Spaceflakes/Sid-FPV-timer/PCB/Sid_FPV_Timer.csv

Reference | Qty | Value | DNP | Exclude from BOM | Exclude from Board | Footprint | Datasheet | LCSC
BT1 | 1 | CR2032-BS-6-1 |  |  |  | Battery:BatteryHolder_Keystone_1060_1x2032 | https://snapeda.s3.amazonaws.com/datasheets/1811061923_Q-J-CR2032-BS-6-1_C70377.pdf
BZ1 | 1 | Buzzer |  |  |  | Hex_FPV_Timer:Buzzer 9650Y
C1 | 1 | 220u |  |  |  | Capacitor_SMD:CP_Elec_10x10 |  | C2887271
C2,C3,C4,C5 | 4 | 4.7u |  |  |  | Capacitor_SMD:C_0603_1608Metric
C6,C7,C8 | 3 | 47u |  |  |  | Capacitor_SMD:C_0603_1608Metric
C9,C10,C21,C22 | 4 | 220n |  |  |  | Capacitor_SMD:C_0603_1608Metric
C11,C23,C31,C32 | 4 | 1u |  |  |  | Capacitor_SMD:C_0603_1608Metric
C12,C24,C26,C27,C28,C33 | 6 | 100n |  |  |  | Capacitor_SMD:C_0603_1608Metric
C13 | 1 | 1p |  |  |  | Capacitor_SMD:C_0603_1608Metric
C14,C15,C16,C17,C29 | 5 | 10u |  |  |  | Capacitor_SMD:C_0603_1608Metric
C18,C19,C20 | 3 | 100u |  |  |  | Capacitor_SMD:C_0603_1608Metric
C25 | 1 | 30p |  |  |  | Capacitor_SMD:C_0603_1608Metric
C30 | 1 | 10n |  |  |  | Capacitor_SMD:C_0603_1608Metric
D1 | 1 | SMC26A |  |  |  | Diode_SMD:D_SMC
D2,D3 | 2 | Red |  |  |  | LED_SMD:LED_0805_2012Metric
D4 | 1 | Blue |  |  |  | LED_SMD:LED_0603_1608Metric
D5,D6 | 2 | Yellow |  |  |  | LED_SMD:LED_0805_2012Metric
FB1 | 1 | 100m, 120r
J1 | 1 | Input |  |  |  | Connector_AMASS:AMASS_XT60PW-M_1x02_P7.20mm_Horizontal
J2 | 1 | Fan 1 |  |  |  | Connector_JST:JST_XA_B02B-XASK-1_1x02_P2.50mm_Vertical
J3 | 1 | Raspberry_Pi_4 |  |  |  | Connector_PinSocket_2.54mm:PinSocket_2x20_P2.54mm_Vertical | https://datasheets.raspberrypi.com/rpi4/raspberry-pi-4-datasheet.pdf
J4 | 1 | LED1 |  |  |  | Connector_JST:JST_XH_B3B-XH-A_1x03_P2.50mm_Vertical
J5 | 1 | LED2 |  |  |  | Connector_JST:JST_XH_B3B-XH-A_1x03_P2.50mm_Vertical
J6 | 1 | FTDI |  |  |  | Connector_PinHeader_2.54mm:PinHeader_1x06_P2.54mm_Vertical
L1 | 1 | 6.8u |  |  |  | Inductor_SMD:L_7.3x7.3_H3.5 |  | C41415571
L2 | 1 | 4.7u |  |  |  | Inductor_SMD:L_7.3x7.3_H3.5 |  | C167220
Q1,Q2 | 2 | AO3400A |  |  |  | Package_TO_SOT_SMD:SOT-23 | http://www.aosmd.com/pdfs/datasheet/AO3400A.pdf
R1,R6 | 2 | 32.4k |  |  |  | Resistor_SMD:R_0603_1608Metric
R2,R3,R7,R8,R12,R20,R21,R22,R23,R24,R25,R26,R27,R28,R29 | 15 | 100k |  |  |  | Resistor_SMD:R_0603_1608Metric
R4,R9,R15,R16,R18,R19 | 6 | 1k |  |  |  | Resistor_SMD:R_0603_1608Metric
R5 | 1 | 24.9k |  |  |  | Resistor_SMD:R_0603_1608Metric
R10 | 1 | 43.2k |  |  |  | Resistor_SMD:R_0603_1608Metric
R11,R13,R14,R30 | 4 | 10k |  |  |  | Resistor_SMD:R_0603_1608Metric
R17 | 1 | 68 |  |  |  | Resistor_SMD:R_0603_1608Metric
SW1 | 1 | SW_Push |  |  |  | Button_Switch_SMD:Panasonic_EVQPUJ_EVQPUA
U1,U2 | 2 | LM61460AFSQRJRRQ1 |  |  |  | TI:IC_LM61460AFSQRJRRQ1
U3 | 1 | ESP32-WROOM-32UE |  |  |  | RF_Module:ESP32-WROOM-32UE | https://www.espressif.com/sites/default/files/documentation/esp32-wroom-32e_esp32-wroom-32ue_datasheet_en.pdf
U4 | 1 | STM32F103C8Tx |  |  |  | Package_QFP:LQFP-48_7x7mm_P0.5mm | https://www.st.com/resource/en/datasheet/stm32f103c8.pdf
U5,U6,U7,U8,U9,U10,U11,U12 | 8 |  |  |  |  | Hex_FPV_Timer:RX5808_Module
Y1 | 1 | 8m |  |  |  | Crystal:Resonator_SMD_Murata_CSTxExxV-3Pin_3.0x1.1mm
