Spaceflakes/Sid-FPV-timer/PCB/Sid_FPV_Timer.kicad_pcb

## KiCad design PCB/Sid_FPV_Timer.kicad_pcb (2026-11-07)

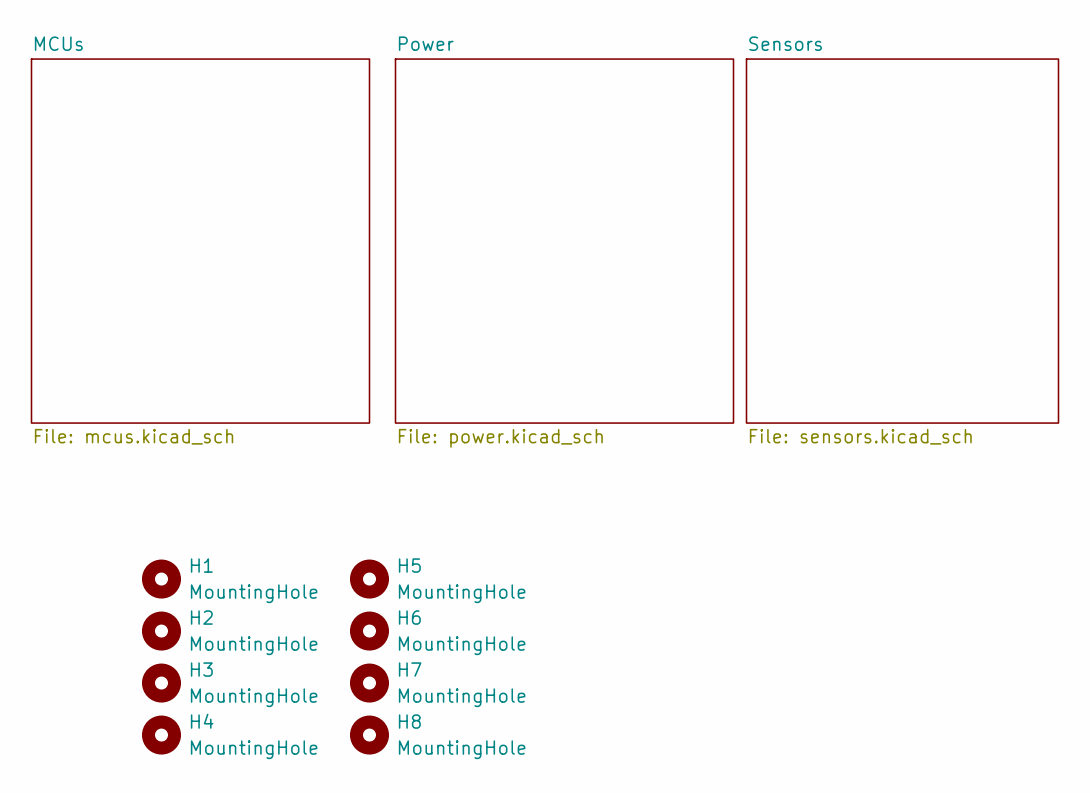
[picture p1: schematic Sid_FPV_Timer.kicad_sch, HEX FPV TIMER]

Parts:
H1, H2, H3, H4: MountingHole; MountingHole_2.7mm_M2.5_Pad_Via
H5, H6, H7, H8: MountingHole; MountingHole_3.2mm_M3_Pad_Via

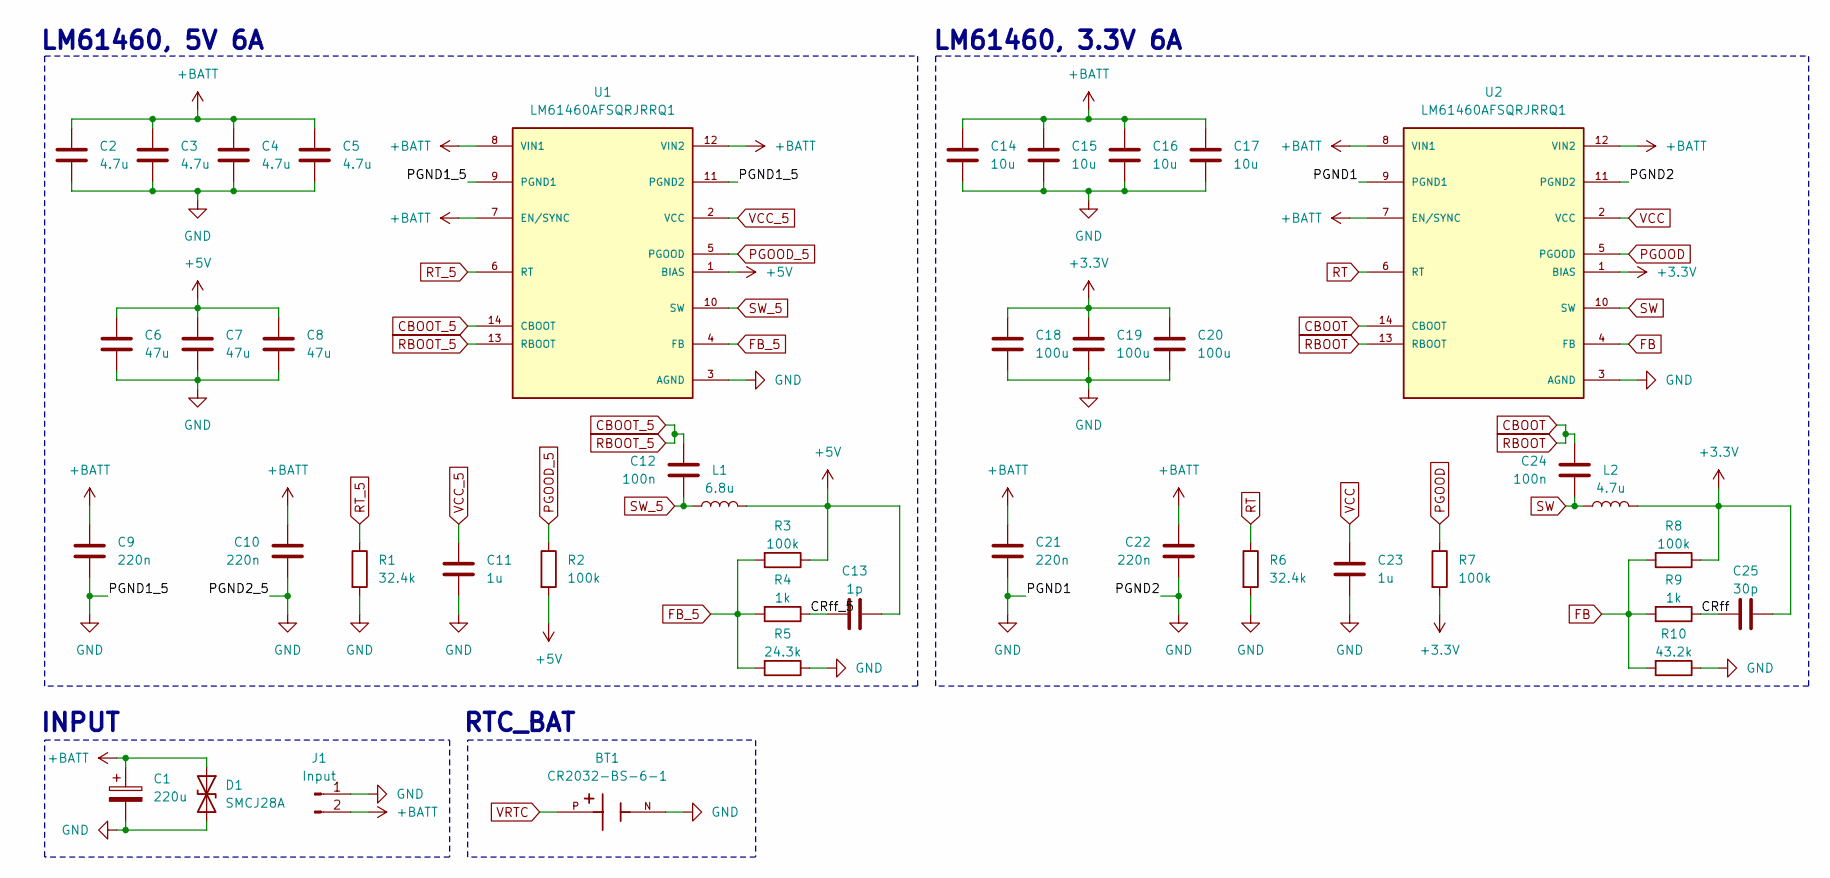
[picture p2: schematic power.kicad_sch]

Parts:
BT1: CR2032-BS-6-1; BatteryHolder_Keystone_1060_1x2032; MPN CR2032-BS-6-1; LCSC C964758
C1: 220u; CP_Elec_10x10; LCSC C2887271
C2, C3, C4, C5: 4.7u; C_0805_2012Metric; LCSC C98192
C6, C7, C8: 47u; C_0603_1608Metric; LCSC C730416
C9, C10, C21, C22: 220n; C_0603_1608Metric; LCSC C64705
C11, C23: 1u; C_0603_1608Metric; LCSC C15849
C12, C24: 100n; C_0603_1608Metric; LCSC C1591
C13: 1p; C_0603_1608Metric; LCSC C5137611
C14, C15, C16, C17: 10u; C_0805_2012Metric; LCSC C440198
C18, C19, C20: 100u; C_0805_2012Metric; LCSC C141660
C25: 30p; C_0603_1608Metric; LCSC C113797
D1: SMCJ28A; D_SMC; LCSC C42371538
J1: Input; AMASS_XT60PW-M_1x02_P7.20mm_Horizontal; LCSC C98732
L1: 6.8u; L_7.3x7.3_H3.5; LCSC C41415571
L2: 4.7u; L_7.3x7.3_H3.5; LCSC C167220
R1, R6: 32.4k; R_0603_1608Metric; LCSC C2982943
R2, R3, R7, R8: 100k; R_0603_1608Metric; LCSC C122538
R4, R9: 1k; R_0603_1608Metric; LCSC C118155
R5: 24.3k; R_0603_1608Metric; LCSC C403097
R10: 43.2k; R_0603_1608Metric; LCSC C2930102
U1, U2: LM61460AFSQRJRRQ1; IC_LM61460AFSQRJRRQ1; PARTREV D; LCSC C2864505

Connections:
+5V: C6.1, C7.1, C8.1, C13.2, L1.2, R2.2, R3.1, U1.1 (BIAS); also elsewhere on the board
+BATT: C1.1, C2.1, C3.1, C4.1, C5.1, C9.1, C10.1, C14.1, C15.1, C16.1, C17.1, C21.1, C22.1, D1.1 (A1), J1.2, U1.7 (EN/SYNC), U1.8 (VIN1), U1.12 (VIN2), U2.7 (EN/SYNC), U2.8 (VIN1), U2.12 (VIN2); also elsewhere on the board
/Power/CRff: C25.1, R9.1
/Power/CRff_5: C13.1, R4.1
CBOOT: C24.2, U2.13 (RBOOT), U2.14 (CBOOT)
CBOOT_5: C12.2, U1.13 (RBOOT), U1.14 (CBOOT)
FB: R8.2, R9.2, R10.2, U2.4 (FB)
FB_5: R3.2, R4.2, R5.2, U1.4 (FB)
GND: BT1.N, C1.2, C2.2, C3.2, C4.2, C5.2, C6.2, C7.2, C8.2, C9.2, C10.2, C11.2, C14.2, C15.2, C16.2, C17.2, C18.2, C19.2, C20.2, C21.2, C22.2, C23.2, D1.2 (A2), J1.1, R1.2, R5.1, R6.2, R10.1, U1.3 (AGND), U1.9 (PGND1), U1.11 (PGND2), U2.3 (AGND), U2.9 (PGND1), U2.11 (PGND2); also elsewhere on the board
PGOOD: R7.1, U2.5 (PGOOD)
PGOOD_5: R2.1, U1.5 (PGOOD)
RT: R6.1, U2.6 (RT)
RT_5: R1.1, U1.6 (RT)
SW: C24.1, L2.1, U2.10 (SW)
SW_5: C12.1, L1.1, U1.10 (SW)
VCC: C23.1, U2.2 (VCC)
VCC_5: C11.1, U1.2 (VCC)
VDD: C18.1, C19.1, C20.1, C25.2, L2.2, R7.2, R8.1, U2.1 (BIAS); also elsewhere on the board
VRTC: BT1.P; also elsewhere on the board

Notes on the sheet:
LM61460, 5V 6A
LM61460, 3.3V 6A
RTC_BAT
INPUT

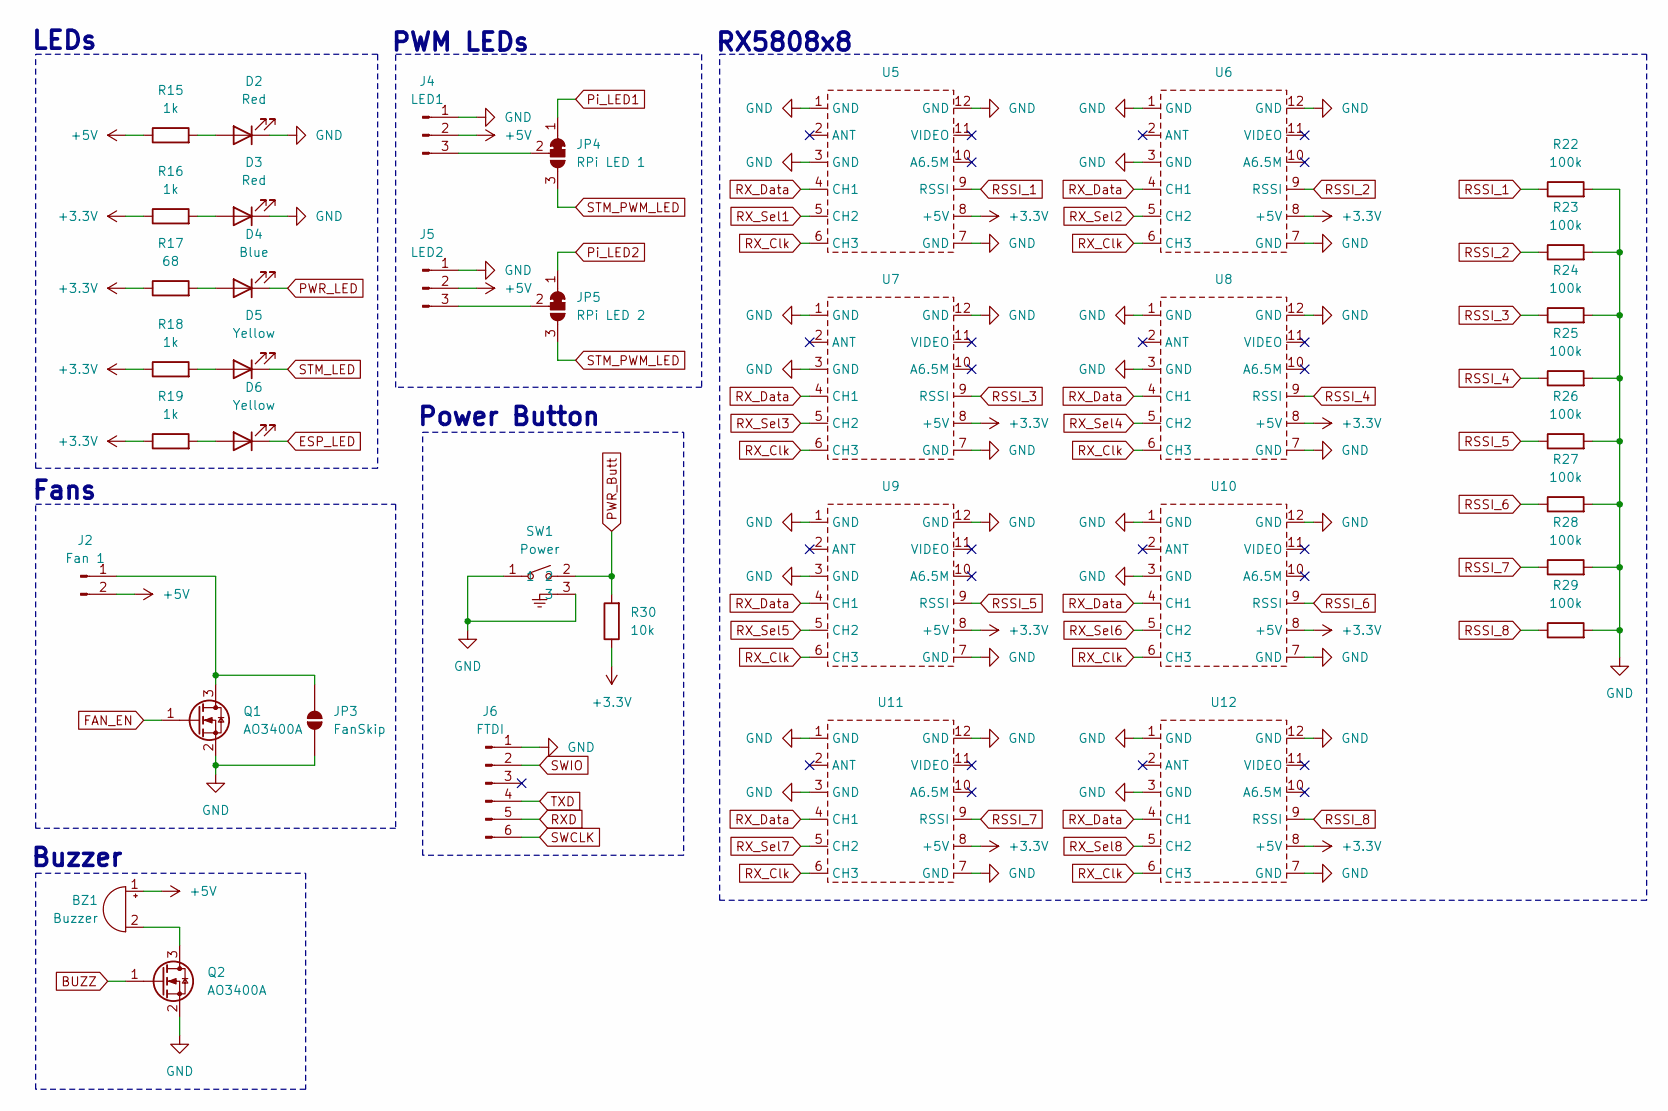
[picture p3: schematic sensors.kicad_sch]

Parts:
BZ1: Buzzer; Buzzer 9650Y; LCSC C96127
D2, D3: Red; LED_0805_2012Metric; LCSC C965812
D4: Blue; LED_0603_1608Metric; LCSC C46610608
D5, D6: Yellow; LED_0805_2012Metric; LCSC C965814
J2: Fan 1; JST_XA_B02B-XASK-1_1x02_P2.50mm_Vertical; LCSC C158012
J4: LED1; JST_XH_B3B-XH-A_1x03_P2.50mm_Vertical; LCSC C144394
J5: LED2; JST_XH_B3B-XH-A_1x03_P2.50mm_Vertical; LCSC C144394
J6: FTDI; PinHeader_1x06_P2.54mm_Vertical
JP3: FanSkip; SolderJumper-2_P1.3mm_Open_RoundedPad1.0x1.5mm
JP4: RPi LED 1; SolderJumper-3_P1.3mm_Bridged12_RoundedPad1.0x1.5mm
JP5: RPi LED 2; SolderJumper-3_P1.3mm_Bridged12_RoundedPad1.0x1.5mm
Q1, Q2: AO3400A; SOT-23; LCSC C20917
R15, R16, R18, R19: 1k; R_0603_1608Metric; LCSC C118155
R17: 68; R_0603_1608Metric; LCSC C27592
R22, R23, R24, R25, R26, R27, R28, R29: 100k; R_0603_1608Metric; LCSC C122538
R30: 10k; R_0603_1608Metric; LCSC C191124
SW1: Power; SW-TH_G-SWITCH_GT-TCB73B-H048-L1; LCSC C2890354
U5, U6, U7, U8, U9, U10, U11, U12: RX5808_Module

Connections:
+5V: BZ1.1 (+), J2.2, J4.2, J5.2, R15.1; also elsewhere on the board
BUZZ: Q2.1 (G); also elsewhere on the board
ESP_LED: D6.1 (K); also elsewhere on the board
FAN_EN: Q1.1 (G); also elsewhere on the board
GND: D2.1 (K), D3.1 (K), J4.1, J5.1, J6.1, JP3.1 (A), Q1.2 (S), Q2.2 (S), R22.2, R23.2, R24.2, R25.2, R26.2, R27.2, R28.2, R29.2, SW1.1, SW1.3, U5.1 (GND), U5.3 (GND), U5.7 (GND), U5.12 (GND), U6.1 (GND), U6.3 (GND), U6.7 (GND), U6.12 (GND), U7.1 (GND), U7.3 (GND), U7.7 (GND), U7.12 (GND), U8.1 (GND), U8.3 (GND), U8.7 (GND), U8.12 (GND), U9.1 (GND), U9.3 (GND), U9.7 (GND), U9.12 (GND), U10.1 (GND), U10.3 (GND), U10.7 (GND), U10.12 (GND), U11.1 (GND), U11.3 (GND), U11.7 (GND), U11.12 (GND), U12.1 (GND), U12.3 (GND), U12.7 (GND), U12.12 (GND); also elsewhere on the board
unnamed: BZ1.2 (-), Q2.3 (D)
unnamed: D2.2 (A), R15.2
unnamed: D3.2 (A), R16.2
unnamed: D4.2 (A), R17.2
unnamed: D5.2 (A), R18.2
unnamed: D6.2 (A), R19.2
unnamed: J2.1, JP3.2 (B), Q1.3 (D)
unnamed: J4.3, JP4.2 (C)
unnamed: J5.3, JP5.2 (C)
PWR_Butt: R30.2, SW1.2; also elsewhere on the board
PWR_LED: D4.1 (K); also elsewhere on the board
Pi_LED1: JP4.1 (A); also elsewhere on the board
Pi_LED2: JP5.1 (A); also elsewhere on the board
RSSI_1: R22.1, U5.9 (RSSI); also elsewhere on the board
RSSI_2: R23.1, U6.9 (RSSI); also elsewhere on the board
RSSI_3: R24.1, U7.9 (RSSI); also elsewhere on the board
RSSI_4: R25.1, U8.9 (RSSI); also elsewhere on the board
RSSI_5: R26.1, U9.9 (RSSI); also elsewhere on the board
RSSI_6: R27.1, U10.9 (RSSI); also elsewhere on the board
RSSI_7: R28.1, U11.9 (RSSI); also elsewhere on the board
RSSI_8: R29.1, U12.9 (RSSI); also elsewhere on the board
RXD: J6.5; also elsewhere on the board
RX_Clk: U5.6 (CH3), U6.6 (CH3), U7.6 (CH3), U8.6 (CH3), U9.6 (CH3), U10.6 (CH3), U11.6 (CH3), U12.6 (CH3); also elsewhere on the board
RX_Data: U5.4 (CH1), U6.4 (CH1), U7.4 (CH1), U8.4 (CH1), U9.4 (CH1), U10.4 (CH1), U11.4 (CH1), U12.4 (CH1); also elsewhere on the board
RX_Sel1: U5.5 (CH2); also elsewhere on the board
RX_Sel2: U6.5 (CH2); also elsewhere on the board
RX_Sel3: U7.5 (CH2); also elsewhere on the board
RX_Sel4: U8.5 (CH2); also elsewhere on the board
RX_Sel5: U9.5 (CH2); also elsewhere on the board
RX_Sel6: U10.5 (CH2); also elsewhere on the board
RX_Sel7: U11.5 (CH2); also elsewhere on the board
RX_Sel8: U12.5 (CH2); also elsewhere on the board
STM_LED: D5.1 (K); also elsewhere on the board
STM_PWM_LED: JP4.3 (B), JP5.3 (B); also elsewhere on the board
SWCLK: J6.6; also elsewhere on the board
SWIO: J6.2; also elsewhere on the board
TXD: J6.4; also elsewhere on the board
VDD: R16.1, R17.1, R18.1, R19.1, R30.1, U5.8 (+5V), U6.8 (+5V), U7.8 (+5V), U8.8 (+5V), U9.8 (+5V), U10.8 (+5V), U11.8 (+5V), U12.8 (+5V); also elsewhere on the board

Notes on the sheet:
Power Button
PWM LEDs
Buzzer
RX5808x8
Fans
LEDs

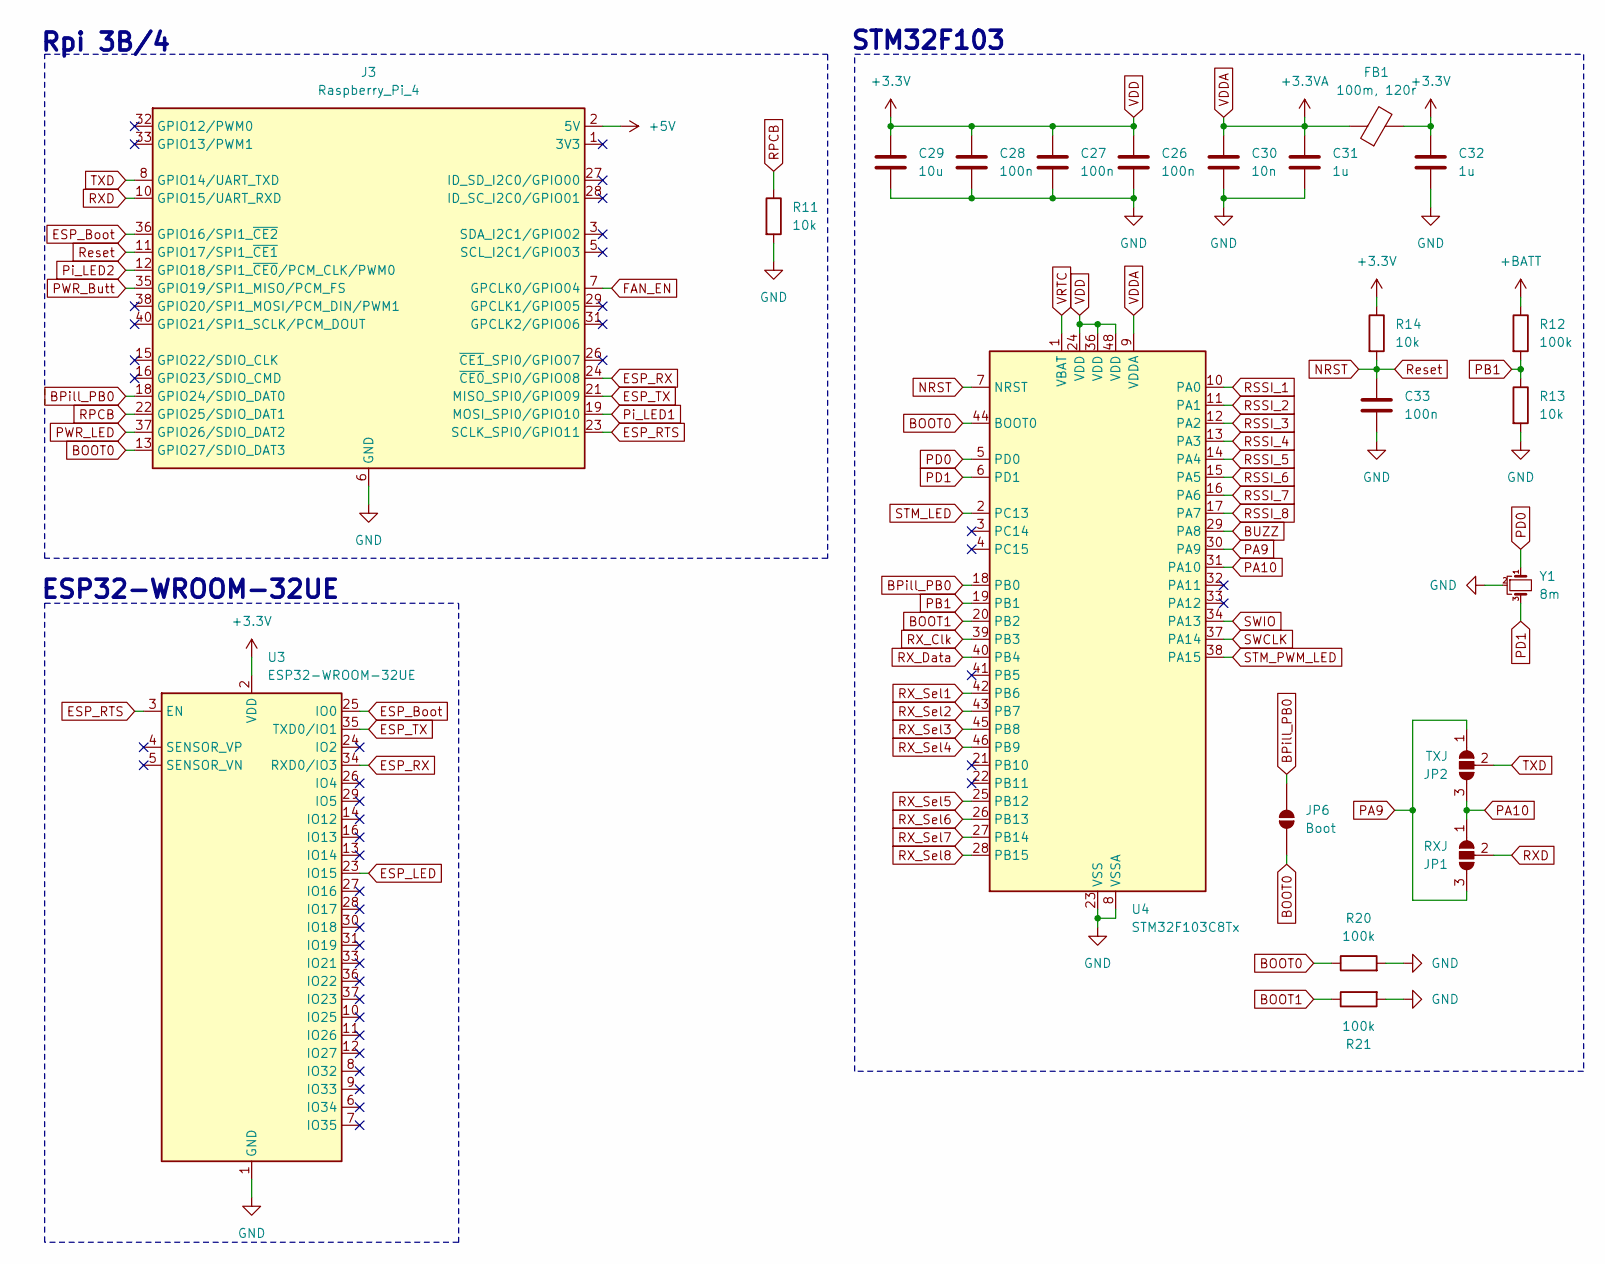
[picture p4: schematic mcus.kicad_sch]

Parts:
C26, C27, C28, C33: 100n; C_0603_1608Metric; LCSC C1591
C29: 10u; C_0603_1608Metric; LCSC C92487
C30: 10n; C_0603_1608Metric; LCSC C100042
C31, C32: 1u; C_0603_1608Metric; LCSC C15849
FB1: 100m, 120r; C_0603_1608Metric; LCSC C76893
J3: Raspberry_Pi_4; PinSocket_2x20_P2.54mm_Vertical; LCSC C2977589
JP1: RXJ; SolderJumper-3_P1.3mm_Open_RoundedPad1.0x1.5mm_NumberLabels
JP2: TXJ; SolderJumper-3_P1.3mm_Open_RoundedPad1.0x1.5mm_NumberLabels
JP6: Boot; SolderJumper-2_P1.3mm_Open_RoundedPad1.0x1.5mm
R11, R13, R14: 10k; R_0603_1608Metric; LCSC C191124
R12, R20, R21: 100k; R_0603_1608Metric; LCSC C122538
U3: ESP32-WROOM-32UE; LCSC C701346
U4: STM32F103C8Tx; LQFP-48_7x7mm_P0.5mm; LCSC C8734
Y1: 8m; Resonator_SMD_Murata_CSTxExxV-3Pin_3.0x1.1mm; LCSC C22549

Connections:
+5V: J3.2 (5V), J3.4 (5V); also elsewhere on the board
+BATT: R12.1; also elsewhere on the board
BOOT0: J3.13 (GPIO27/SDIO_DAT3), JP6.1 (A), R20.1, U4.44 (BOOT0)
BOOT1: R21.1, U4.20 (PB2)
BPill_PB0: J3.18 (GPIO24/SDIO_DAT0), JP6.2 (B), U4.18 (PB0)
BUZZ: U4.29 (PA8); also elsewhere on the board
ESP_Boot: J3.36 (GPIO16/SPI1_~CE2), U3.25 (IO0)
ESP_LED: U3.23 (IO15); also elsewhere on the board
ESP_RTS: J3.23 (SCLK_SPI0/GPIO11), U3.3 (EN)
ESP_RX: J3.24 (~CE0_SPI0/GPIO08), U3.34 (RXD0/IO3)
ESP_TX: J3.21 (MISO_SPI0/GPIO09), U3.35 (TXD0/IO1)
FAN_EN: J3.7 (GPCLK0/GPIO04); also elsewhere on the board
GND: C26.2, C27.2, C28.2, C29.2, C30.2, C31.2, C32.2, C33.2, J3.6 (GND), J3.9 (GND), J3.14 (GND), J3.20 (GND), J3.25 (GND), J3.30 (GND), J3.34 (GND), J3.39 (GND), R11.2, R13.2, R20.2, R21.2, U3.1 (GND), U3.15 (GND), U3.38 (GND), U3.39 (GND), U4.8 (VSSA), U4.23 (VSS), U4.35 (VSS), U4.47 (VSS), Y1.2; also elsewhere on the board
NRST: C33.1, J3.11 (GPIO17/SPI1_~CE1), R14.2, U4.7 (NRST)
PA9: JP1.3 (B), JP2.1 (A), U4.30 (PA9)
PA10: JP1.1 (A), JP2.3 (B), U4.31 (PA10)
PB1: R12.2, R13.1, U4.19 (PB1)
PD0: U4.5 (PD0), Y1.1
PD1: U4.6 (PD1), Y1.3
PWR_Butt: J3.35 (GPIO19/SPI1_MISO/PCM_FS); also elsewhere on the board
PWR_LED: J3.37 (GPIO26/SDIO_DAT2); also elsewhere on the board
Pi_LED1: J3.19 (MOSI_SPI0/GPIO10); also elsewhere on the board
Pi_LED2: J3.12 (GPIO18/SPI1_~CE0/PCM_CLK/PWM0); also elsewhere on the board
RPCB: J3.22 (GPIO25/SDIO_DAT1), R11.1
RSSI_1: U4.10 (PA0); also elsewhere on the board
RSSI_2: U4.11 (PA1); also elsewhere on the board
RSSI_3: U4.12 (PA2); also elsewhere on the board
RSSI_4: U4.13 (PA3); also elsewhere on the board
RSSI_5: U4.14 (PA4); also elsewhere on the board
RSSI_6: U4.15 (PA5); also elsewhere on the board
RSSI_7: U4.16 (PA6); also elsewhere on the board
RSSI_8: U4.17 (PA7); also elsewhere on the board
RXD: J3.10 (GPIO15/UART_RXD), JP1.2 (C); also elsewhere on the board
RX_Clk: U4.39 (PB3); also elsewhere on the board
RX_Data: U4.40 (PB4); also elsewhere on the board
RX_Sel1: U4.42 (PB6); also elsewhere on the board
RX_Sel2: U4.43 (PB7); also elsewhere on the board
RX_Sel3: U4.45 (PB8); also elsewhere on the board
RX_Sel4: U4.46 (PB9); also elsewhere on the board
RX_Sel5: U4.25 (PB12); also elsewhere on the board
RX_Sel6: U4.26 (PB13); also elsewhere on the board
RX_Sel7: U4.27 (PB14); also elsewhere on the board
RX_Sel8: U4.28 (PB15); also elsewhere on the board
STM_LED: U4.2 (PC13); also elsewhere on the board
STM_PWM_LED: U4.38 (PA15); also elsewhere on the board
SWCLK: U4.37 (PA14); also elsewhere on the board
SWIO: U4.34 (PA13); also elsewhere on the board
TXD: J3.8 (GPIO14/UART_TXD), JP2.2 (C); also elsewhere on the board
VDD: C26.1, C27.1, C28.1, C29.1, C32.1, FB1.2, R14.1, U3.2 (VDD), U4.24 (VDD), U4.36 (VDD), U4.48 (VDD); also elsewhere on the board
VDDA: C30.1, C31.1, FB1.1, U4.9 (VDDA)
VRTC: U4.1 (VBAT); also elsewhere on the board

Notes on the sheet:
ESP32-WROOM-32UE
Rpi 3B/4
STM32F103

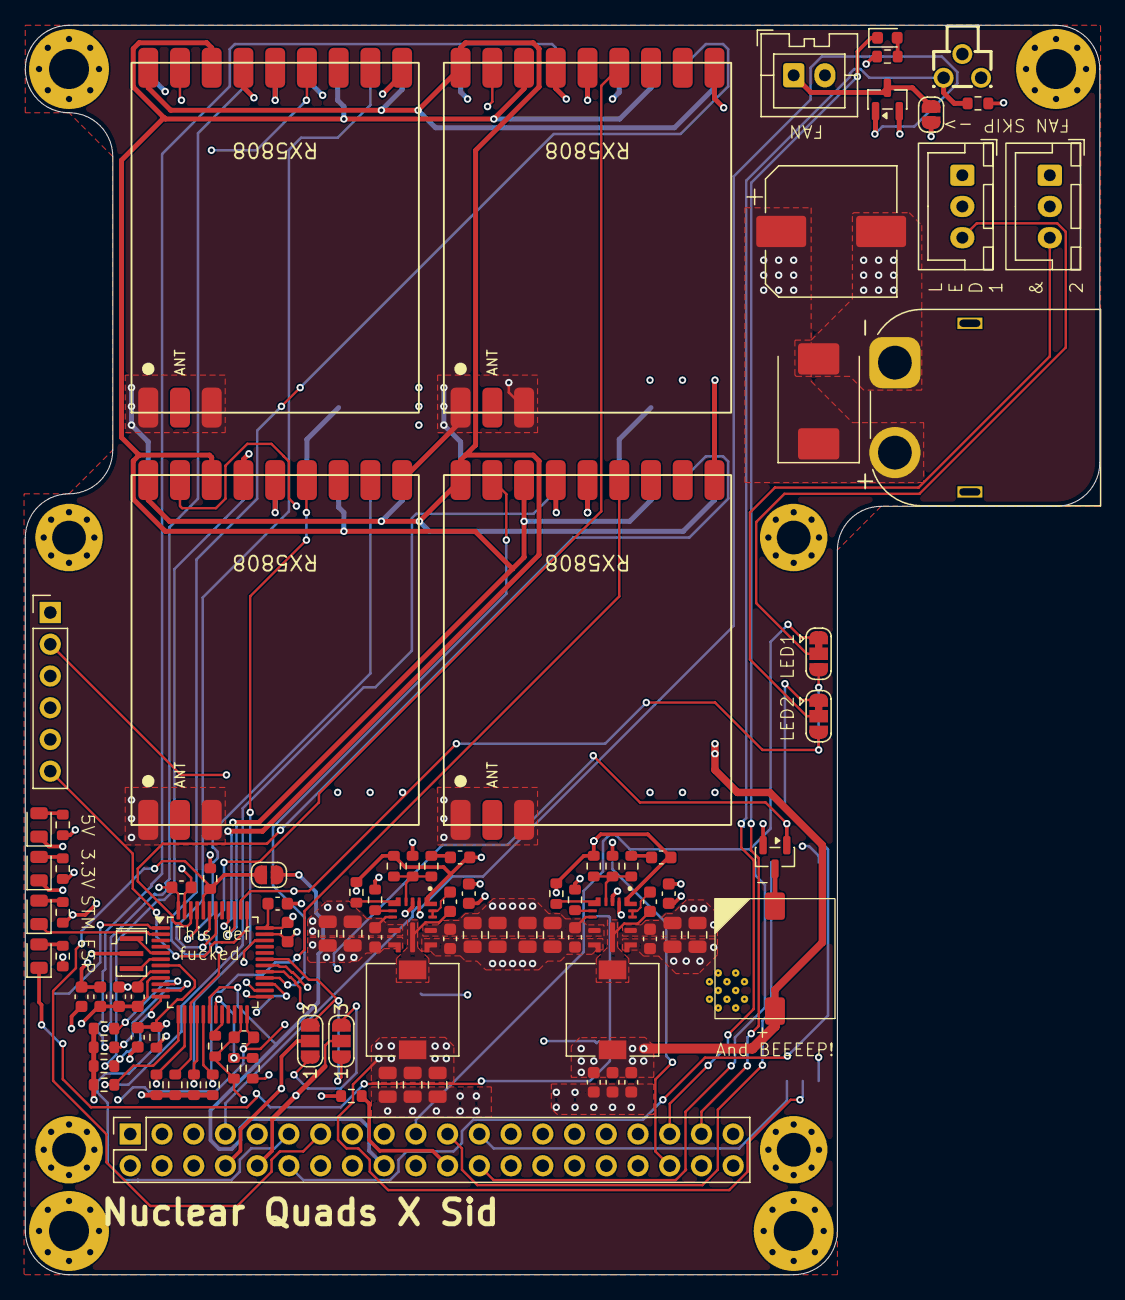
[picture p5: board Sid_FPV_Timer.kicad_pcb from above]

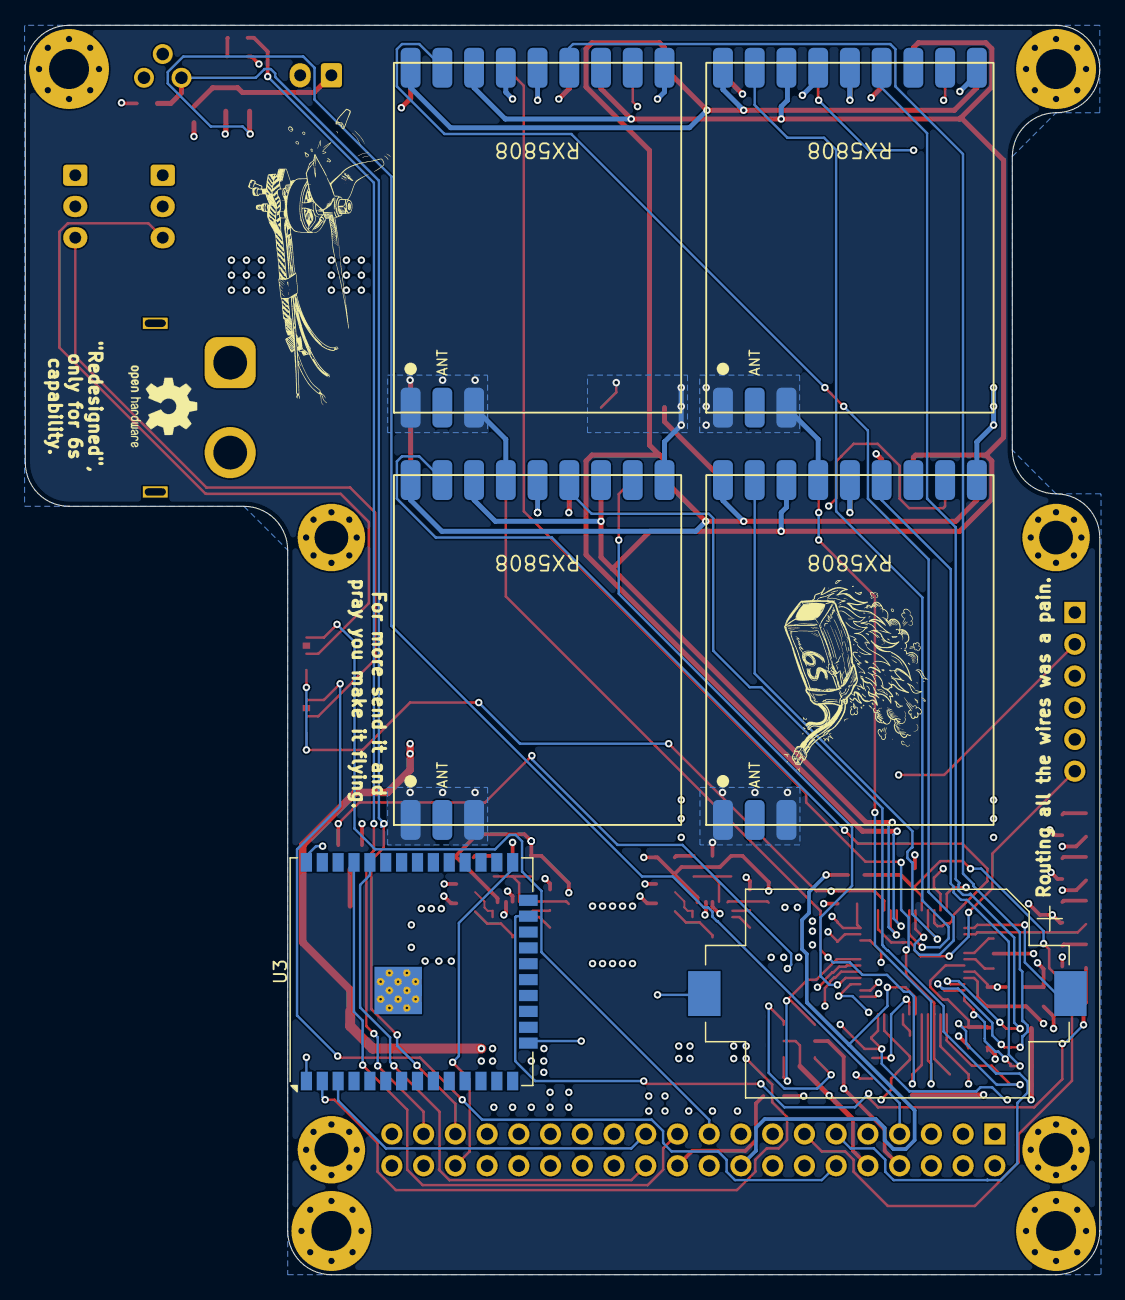
[picture p6: board Sid_FPV_Timer.kicad_pcb from below]

Board: 4 copper layers, 86.0 x 100.0 mm, 110 parts (6 on the bottom side), 74 nets.
